redhasanh1/pinn-humanoid/robotai_BOM.xlsx

Sheet: BOM
robotai - Phase 1: Two InMoov-style robotic hands - Bill of Materials
All prices CAD, read from the linked pages on 2026-09-27. 3D-printed parts excluded (printing covered). Blue cells = inputs (edit price/qty); totals recalc automatically.
Budget (CAD) | $500.00 | Sales tax rate (ON HST) | 13%
CORE BOM
Item | Product Name | Link | Unit Price (CAD) | Quantity | Line Total (CAD) | Notes/Rationale
ESP32 dev board (x2, one per hand) | Freenove ESP32 Development Board ESP32 Kit (2 Pack) | https://www.amazon.ca/dp/B0C9THDPXP | $27.95 | 1 |  | One 2-pack covers both hands ($13.98/board). ESP32-WROOM, 4.4* (527), well documented.
Finger servos (10 + 2 spares) - GOOD tier | Deegoo-FPV MG996R Metal Gear Digital Servo, 4-Pack | https://www.amazon.ca/dp/B07MFK266B | $35.22 | 3 |  | 12 metal-gear standard servos, ~12 kg-cm @6V, $8.81/ea, 4.5* (1,182). Fits stock InMoov forearm. Showed 'only 6 left' - fallback: Aideepen MG996R 6-pack x2 (see Alternatives).
Servo driver (x2, one per hand) | HiLetgo PCA9685 16-Channel 12-Bit PWM Servo Driver (I2C), 2-Pack | https://www.amazon.ca/dp/B07BRS249H | $24.14 | 1 |  | Adafruit-layout clone, works with Adafruit PWM library on ESP32. One board per hand matches 1-ESP32-per-hand; a single board (16 ch) could drive all 10 servos but would tie both hands to one ESP32.
Servo power supply (x2, one per hand) | SHNITPWR 3.5-12V Adjustable 10A 120W Power Supply w/ LCD | https://www.amazon.ca/dp/B08N4FB7MF | $36.99 | 2 |  | Set to 6V. 10A = 5 MG996R running + 2-3 stalled (~2.5A stall each). LCD guards against accidental 12V. 4.3* (216). Servos NEVER on ESP32 5V pin; tie grounds.
DC barrel-jack to screw-terminal adapters | 20 PCS Female DC 5.5x2.1mm Barrel to Screw Terminal | https://www.amazon.ca/dp/B0C4JJ2HB4 | $11.99 | 1 |  | Connects PSU to PCA9685 V+ terminal. Small jacks run warm near 10A - cutting the plug and screwing wire in is safer.
Tendon line (shared spool) | HERCULES 8-Strand Braided PE Fishing Line, 50lb, 0.37mm, 100m | https://www.amazon.ca/dp/B0791D5G7J | $16.99 | 1 |  | InMoov-class braid, low stretch; 100m is far more than both hands need. 4.5* (7.7K). Price for 50lb/100m variant.
Finger return springs | Swpeet 150pc Stainless Extension Spring Assortment (15 sizes x 10) | https://www.amazon.ca/dp/B0D7W3RT31 | $20.99 | 1 |  | 10 of each size, so 10 matching springs per size for 10 fingers, lets you tune return force. 4.6* (111).
Jumper wire kit | ELEGOO 120pc 20cm Dupont Wire (40 M-F / 40 M-M / 40 F-F) | https://www.amazon.ca/dp/B01EV70C78 | $12.99 | 1 |  | Signal/I2C wiring ESP32<->PCA9685. 4.7* (14.8K). One kit covers both hands.
Servo extension cables | 10pc 30cm 3-Pin Servo Extension Cable (JR, F-M) | https://www.amazon.ca/dp/B09VGDJ6Z8 | $8.27 | 1 |  | Forearm servos to PCA9685 headers. Free shipping but slow (est. Oct 20-Nov 9); Prime alt in Alternatives.
Servo power wire | BNTECHGO 18 AWG Silicone Wire, Red/Black, 10ft | https://www.amazon.ca/dp/B01AQOI36M | $13.44 | 1 |  | 18AWG handles the 10A servo bus; Dupont wire (24AWG) must not carry servo power. 4.5* (438).
Core subtotal (pre-tax)
Est. HST on core (13%, shipping not included)
CORE TOTAL incl. tax
Headroom under budget
Under $500 CAD?
OPTIONAL - fingertip force sensors (NOT in core total)
Item | Product Name | Link | Unit Price (CAD) | Quantity | Line Total (CAD) | Notes/Rationale
Fingertip force sensors (x2, proof of concept) | Interlink FSR 402 (30-81794), genuine - DigiKey.ca | https://www.digikey.ca/en/products/detail/interlink-electronics/30-81794/2476468 | $10.43 | 2 |  | One per hand (e.g. index finger) on an ESP32 ADC pin via 10k divider. Qty-1 price break $10.43; qty 10 drops to $9.02/ea ($90.19) if you want all fingertips. DigiKey shipping for small orders NOT verified (free over $100 CAD). Amazon clones have 1 review - avoid.
Optional subtotal (pre-tax)
Core + optional, incl. tax
Still under $500 with sensors?
Notes
RECOMMENDATION: buy the core list + the 2 FSRs. Both fit comfortably under $500 CAD with tax, leaving room for shipping and a spare servo pack.
If you later want all 10 fingertips sensed, the DigiKey 10-pack ($90.19) still keeps core + sensors under $500 with tax.
Wiring rule: ESP32 3.3V/GND -> PCA9685 VCC/GND, SDA/SCL -> GPIO21/22. PSU (6V) -> PCA9685 V+ screw terminal. Common ground between PSU and ESP32. Never feed servos from the ESP32 5V pin.
Not included: shipping (most Amazon.ca items ship free with Prime or over $35), tools (soldering iron, crimper), and fasteners/bearings from the InMoov print list.
Prices change daily - re-check the links before ordering. See 'Alternatives' for budget/premium swaps and 'Phase 2 - Full robot' for arms/base.

Sheet: Alternatives
Alternatives & swaps (not in any total unless you swap them in)
Item | Product Name | Link | Pack Price (CAD) | Packs | Line Total (CAD) | Notes/Rationale
Servos - BUDGET tier | Miuzei MG90S Metal Gear Micro Servo, 10-Pack | https://www.amazon.ca/dp/B0BWJ26PX2 | $39.99 | 1 |  | Saves $65.67 vs MG996R, but only ~2 kg-cm and micro size: needs a remixed (non-stock) InMoov forearm. 4.5* (784).
Servos - cheapest metal-gear standard | Aideepen MG996R, 6-Pack | https://www.amazon.ca/dp/B09LS7RB5J | $39.99 | 2 |  | 12 servos for $79.98. Fallback if Deegoo sells out. Price from search results page. 4.3* (123).
Servos - alt MG996R | Miuzei MG996R Metal Gear, 4-Pack | https://www.amazon.ca/dp/B0BZ4N367M | $42.99 | 3 |  | Spec'd 15.2 kg-cm @6V. 4.4* (163).
Servos - PREMIUM tier | Miuzei 20KG DS3218 Metal Gear Digital, 180deg, 4-Pack | https://www.amazon.ca/dp/B0FH53CKCS | $65.99 | 3 |  | ~20 kg-cm, stronger grip; $197.97 for 12 (+$92 vs core). Search results price. 4.6* (47).
Servo driver - single board | JZK PCA9685 16-Channel PWM Driver (single) | https://www.amazon.ca/dp/B06XSFFXQY | $10.59 | 1 |  | One board can run all 10 servos, but then one ESP32 drives both hands. 4.3* (222).
Power - alt per-hand PSU | SHNITPWR 3.5-12V 12A 144W Adjustable | https://www.amazon.ca/dp/B0CKXW6ZCJ | $36.79 | 2 |  | More headroom, same price. 4.1* (102).
Power - ONE supply for both hands | Aclorol 5V 20A 100W Switching PSU (screw terminals) | https://www.amazon.ca/dp/B07KC55TJF | $39.44 | 1 |  | Saves ~$34 but max ~5.75V (less torque), single point of failure, exposed mains terminals need a cover. Needs AC cord below. 4.5* (182).
Power - AC cord for 20A PSU | Bergen 3ft 16AWG 3-wire pigtail cord | https://www.amazon.ca/dp/B07BQCMPF2 | $6.87 | 1 |  | Only with the single-PSU option. Search results price.
Barrel adapters - small pack | 2 Male + 2 Female 5.5x2.1 to Screw Terminal | https://www.amazon.ca/dp/B07JMY5XXT | $9.35 | 1 |  | Search results price. 4.6* (114).
Tendon - alt | Reaction Tackle Braided Line 50lb 150yd | https://www.amazon.ca/dp/B01MRMI7R1 | $21.41 | 1 |  | 4.3* (26.5K). Diameter not listed.
Springs - alt | Glarks 100pc Extension Springs, 25 sizes x 4 | https://www.amazon.ca/dp/B0D7CP84F4 | $20.95 | 1 |  | Only 4 per size - not enough matching springs for 10 fingers.
Jumper kit - alt | 240pc 10cm+20cm Jumper Wire Kit | https://www.amazon.ca/dp/B0BTT48V7P | $15.99 | 1 |  | Search results price. 4.6* (551).
Servo extensions - Prime alt | 10pc 30cm 3-Pin Servo Extension (Futaba/JR) | https://www.amazon.ca/dp/B07NJB58XC | $11.99 | 1 |  | Shipped by Amazon (faster). 4.4* (40).
Power wire - longer | BNTECHGO 18 AWG Silicone Wire 25ft | https://www.amazon.ca/dp/B07HGTKQ89 | $19.82 | 1 |  | Search results price.
FSR - 10 genuine (all fingertips) | Interlink FSR 402 (30-81794) x10 - DigiKey.ca | https://www.digikey.ca/en/products/detail/interlink-electronics/30-81794/2476468 | $90.19 | 1 |  | $9.02/ea at qty 10; one per fingertip on both hands.
FSR - Amazon clone | RELAND SUN FSR402-short (clone), sold singly | https://www.amazon.ca/dp/B0B5F7JDT5 | $8.19 | 10 |  | Only 1 review, +$9.50 shipping. Not recommended.

Sheet: Phase 2 - Full robot
Phase 2 - Life-size InMoov humanoid v1 (both arms on stock InMoov STLs + wheeled base) - prices in CAD
Both arms C$452.30 pre-tax (cap C$500). Whole phase 2 C$1077.15; plus the hands cart (already bought) C$316.40. Arm servos per arm: omoplate, rotate, bicep = DS5160 60 kg with the pot moved to the joint (Gael's mod); shoulder = DS5160 pot in place, limited 0-80; wrist + 5 fingers = owned MG996R. DS5160 is the HS-805BB footprint (65x30 mm) but 10 mm shorter: expect a printed spacer under the tabs; test-fit one before printing everything. Exact drop-in is the PDI-HV2060MG (~C$54 each, would break the cap). Removed vs round 3: 8x NFP 5840 worm motors, 8x BTS7960, 8x AS5600 (custom-arm parts that don't mount in InMoov STLs). The owned PCA9685s drive the arm servos.
 |  | USD->CAD rate (assumed, verify) | 1.38
Item | Product / Vendor | Link | Unit Price (CAD) | Quantity | Line Total (CAD) | Notes/Rationale
ARM: Big arm servos (omoplate, shoulder, rotate, bicep x 2 arms) | DS5160 SSG 60 kg HV digital servo, 180deg variant (RC Toys Upgrade Haven Store, 4.9 stars, 471 sold) | https://www.aliexpress.com/item/1005005676958064.html | $32.84 | 8 |  | ALIEXPRESS, FLAGGED: Amazon.ca DS5160 listings are C$50-57 each (one visible at C$56.75), so 8 of them would take C$400-450 of the C$500 cap. AliExpress shows free shipping. Pick the 180deg variant, not 270. 58 kg-cm at 6 V / 70 kg-cm at 8.4 V, about 2.5x an HS-805BB. The price could be a first-order deal, so re-check it in the cart. Amazon.ca fallback: ANNIMOS 60KG B07KTSCN4J (194 ratings), ZOSKAY B07K48FQ1N (85), 2-pack B09JGBW9KZ. [verified-on-page (AliExpress item page, C$32.84, free shipping)]
ARM: Arm servo power (one per arm, set to 7.4 V) | SHNITPWR 3.5-12V adjustable 12A 144W PSU | https://www.amazon.ca/dp/B0CKXW6ZCJ | $36.79 | 2 |  | Same family as the hand PSUs you already own. Each one runs the 4 big servos of one arm. The worm joints hold their position with the power off, so only 1-2 servos load up at a time. Gael runs a single 6 V 40-60 A supply for the whole robot; splitting per arm means one supply can't brown out the whole robot. Alternative: Aclorol 5V 60A B07KC3KSHP at C$51.38 (verified on the search page), but it only reaches about 5.5 V. [price from the existing bom.json alternatives (earlier check), not re-verified today because Amazon.ca hides prices on a Santa Clara address]
ARM: M3/M4 countersunk bolts + nuts | DYWISHKEY 500pcs M3 M4 M5 304 stainless flat-head countersunk socket cap screws + nuts | https://www.amazon.ca/dp/B08QD6TT2N | $35.47 | 1 |  | InMoov BOM calls for about 50x M3x20 and 50x M4x20 countersunk, plus M3 nuts. Check the kit goes up to 20 mm (the thesis lists 3 mm screws at 12/20/30/35 mm). This overlaps the phase2 'Hardware' line (LuKaiSen kit C$15.99); you can drop that kit's screws and keep only the heat-set inserts. [verified on the Amazon.ca search results page (C$35.47, 55 ratings)]
ARM: Spare 10k pots for the pot-relocation mod | uxcell WH148 10K rotary potentiometer, 10 pcs | https://www.amazon.ca/dp/B07JM62B3Q | $13.99 | 1 |  | The first choice is to reuse each servo's own pot on an extension lead (Gael: cut the wires and splice in length, don't desolder at the PCB). Builders break these pots by over-rotating them, so spares are needed. The pot works as a voltage divider, so a 10k pot replacing a ~5k pot still works. Gael uses round pots (PivPotentioRound) and a square version exists; a WH148 needs a holder like Thingiverse thing:6923985 (shoulder, metal linear pot) or thing:1464929 (bicep, square pot). The listing title says 'Dual'; if it turns out to be dual-gang, use one gang. [verified on the Amazon.ca search results page (C$13.99); single vs dual gang not confirmed]
ARM: 6 mm BBs for the shoulder/rotate ball races | Lancer Tactical 0.20 g 6 mm BBs, 4000-round bag | https://www.amazon.ca/dp/B00HC1U0LO | $13.00 | 1 |  | Per arm: PivCenter 27 + PivMit 31 + RotCenter 27 + RotMit 31 = 116 balls, so 232 for both arms. The classic InMoov arm needs no other ball bearings. Gael warns that some greases dissolve plastic BBs, so use PTFE/silicone grease only. Canadian Tire sells the same BBs for about the same price. [estimate (Amazon.ca hides the price for this delivery address)]
ARM: Servo extension leads (pot relocation + reaching the PCA9685) | 10pc 30cm 3-pin servo extension cable (JR, F-M) | https://www.amazon.ca/dp/B09VGDJ6Z8 | $8.27 | 2 |  | 3 relocated pots per arm need 25-35 cm leads, plus the 8 big servos need to reach the controller. Same SKU as the phase1 cart. [price from phase1 bom.json (earlier check)]
ARM: Servo mounting wood screws | Self-tapping screw assortment incl. M3x12 and 3.5x16 mm (4 per big servo) | https://www.amazon.ca/s?k=self+tapping+screw+assortment+m3 | $10.00 | 1 |  | InMoov BOM: about 100x M3x12 for small servos and about 50x M4x20 for large servos. Use a hardware store if that's cheaper. [estimate]
ARM: M8 through-bolts | M8x90-100 mm bolts + nylock nuts (about 6) | https://www.homedepot.ca/ | $15.00 | 1 |  | One M8x90 per shoulder-to-Clavi joint, plus the elbow and wrist axles (the wrist uses an 8 mm x 6 cm bolt). The InMoov BOM lists about 15x M8x100 for the whole robot. A hardware store is cheapest. [estimate]
ARM: Worm/gear grease | PTFE grease (Super Lube 21030 class) | https://www.amazon.ca/s?k=super+lube+ptfe+grease | $12.00 | 1 |  | Needed on the PivWorm/RotWorm and the ball races. Must not attack ABS/PLA or the plastic BBs. [estimate]
Neck x2 + spares | Feetech STS3215 12V 30 kg-cm bus servo, 6-pack (official store) | https://www.aliexpress.com/item/1005008670304643.html | $166.42 | 1 |  | C$160.99 + C$5.43 shipping, 4.9 stars, 232 sold. Checked on the page. Wrists moved to the owned MG996Rs (InMoov wrist uses MG996R).
Drive base | Used hoverboard (2x 350 W hub motors + 36 V pack) | https://www.kijiji.ca/b-city-of-toronto/hoverboard/k0c170l1700273 | $120.00 | 1 |  | C$50-150 on Kijiji Toronto (43 ads). Open it before paying: single mainboard with STM32F103RCT6/RET6 or GD32F103RCT6 only; walk away from AT32F403/413 boards. Runs EFeru FOC firmware (free).
Base power converter | DC-DC buck 30-60 V in -> 12 V, 15 A+ | https://www.amazon.ca/ | $40.00 | 1 |  | Estimate C$35-45. Must accept 42 V (a 36 V pack charges to 42 V), so an 18-36 V input unit will fail.
Casters (x2) | 2 in swivel casters | https://www.amazon.ca/ | $20.00 | 1 |  | Estimate. Stabilize the tall torso on the hoverboard base.
Safety + power wiring | E-stop button, fuses, XT60 connectors, 14 AWG wire | https://www.amazon.ca/ | $30.00 | 1 |  | Estimate. Non-negotiable for a 1.8 m robot on wheels.
Servo bus adapters (x2) | Waveshare Bus Servo Adapter (A) | https://www.waveshare.com/bus-servo-adapter-a.htm | $6.99 | 2 |  | US$4.99 on waveshare.com; Canada shipping not checked.
Head camera | EMEET C960 1080p webcam | https://www.amazon.ca/dp/B07M6Y7355 | $34.99 | 1 |  | 4.4 stars, 32.5K ratings.
Wrist cameras (x2) | 1080p UVC wide-angle camera module | https://www.aliexpress.com/w/wholesale-wide-angle-usb-camera.html | $12.00 | 2 |  | Estimate. Can wait until week 3.
Balance / motion sensor | BNO085 9-axis IMU (clone) | https://www.aliexpress.com/w/wholesale-bno085.html | $17.58 | 1 |  | Adafruit original is C$33-40.
Servo cables (x2 packs) | 5264 3-pin bus servo cable, 10-pack | https://www.aliexpress.com/item/1005008074862037.html | $6.72 | 2 |  | + ~C$8 shipping.
Powered USB hub | 7-port powered USB 3.0 hub (TP-Link UH700 class) | https://www.amazon.ca/dp/B00OTK16FK | $65.00 | 1 |  | Checked: C$59-71 for reputable hubs.
Hardware | M2/M3/M4 screw kit + 100 M3 heat-set inserts | https://www.amazon.ca/ | $27.00 | 1 |  | LuKaiSen kit C$15.99 + HANGLIFE inserts C$10.99.
Work stand clamps | WEN CLC424 C-clamps, 2-pack | https://www.amazon.ca/dp/B08SQFT9TW | $17.44 | 1 |  | Holds the torso on the bench during arm bring-up.
Wire + connectors | Assorted wire, JST/Dupont, heat shrink | https://www.amazon.ca/ | $35.00 | 1 |  | Estimate.
Phase 2 subtotal (CAD, pre-tax/shipping)
Whole v1 incl. the hands cart (Phase 1 core)
Under the C$1,500 budget by
Cerebras = System-2 brain (planner, voice, replanning, success checks) in the cloud; ACT/SmolVLA motor policy runs locally at 30-50 Hz. See research brief.

Sheet: Phase 3 - Tools
Phase 3 - Tools + last parts (in the Amazon.ca cart, NOT ordered yet)
Checked with Kimi (senior build manager) on 2026-09-27: cut the crimper and breadboard, swapped the wrench set for one 13 mm wrench, added nylock nuts, files, sandpaper, knife, tweezers, fuses, switch. Breadboard kit re-added at Hasan's request (Kimi had marked it optional). Recheck vs orders: the DC barrel-to-screw adapters from Phase 1 were never ordered; added.
Item | Product Name | Link | Unit Price (CAD) | Quantity | Line Total (CAD) | Notes/Rationale
Head camera (robot's live eyes) | InnoMaker 1080P USB UVC camera, 130deg wide | https://www.amazon.ca/dp/B0CNCSFQC1 | $28.00 | 1 |  | Board 38 x 38 mm, plugs into USB, no driver. Kimi: keep.
Arm pivot bolts | M8 x 100 mm socket cap bolts, 10-pack | https://www.amazon.ca/dp/B07KRTHJZR | $11.41 | 1 |  | 8 mm thick, 100 mm long. Shoulder, bicep, omoplate pivots (InMoov BOM: M8x100 x15).
Lock nuts for the M8 bolts | M8 x 1.25 nylon-insert lock nuts, 20 pcs | https://www.amazon.ca/dp/B075ZZY166 | $8.99 | 1 |  | 13 mm across. Stops the pivot bolts backing out.
13 mm wrench (for M8 nuts) | Sunex 13 mm combination wrench | https://www.amazon.ca/dp/B00BNS8W2Q | $9.82 | 1 |  | Only size the M8 nuts need.
Ball race balls | 6 mm 0.20 g airsoft BBs | https://www.amazon.ca/dp/B07T3K1TMS | $12.39 | 1 |  | 6 mm balls. 31 per bicep race, 62+ for two arms.
Grease for the ball races | Super Lube 92003 silicone grease | https://www.amazon.ca/dp/B0081JE0OO | $25.55 | 1 |  | For the printed gears and races.
Joint position sensors | uxcell WH148 10k potentiometers, 10 pcs | https://www.amazon.ca/dp/B07JM62B3Q | $13.99 | 1 |  | Shaft 6 mm. Pot relocated to the joint (InMoov mod).
Servo extension leads | 30 cm 3-pin servo extension, 5 pcs | https://www.amazon.ca/dp/B07DMTYQ6N | $10.32 | 2 |  | 30 cm each, 10 total.
Power plug adapters (PSU to boards) | 20 pcs 5.5 x 2.1 mm DC barrel to screw terminal | https://www.amazon.ca/dp/B0C4JJ2HB4 | $11.99 | 1 |  | Was in the Phase 1 plan but never ordered. Connects the 2 power supplies to the PCA9685 servo boards.
Wire joiners | WAGO 221 lever connectors, 25 pcs | https://www.amazon.ca/dp/B0BYBHYLG2 | $29.39 | 1 |  | Join power wires without soldering.
Fuses | 12 AWG inline fuse holders, 4 pcs | https://www.amazon.ca/dp/B0FDJYRGB7 | $9.99 | 1 |  | 10 A fuse on each power supply line.
Main power switch | Nilight rocker switch 20 A | https://www.amazon.ca/dp/B06ZZHX6K3 | $4.62 | 1 |  | One switch kills servo power.
Screwdrivers | STREBITO 124-piece precision screwdriver set | https://www.amazon.ca/dp/B0968D5PSC | $25.99 | 1 |  | Phillips PH0-PH2 + hex bits for M2-M4 screws.
Hex keys | GEARWRENCH 9-piece metric ball-end hex keys | https://www.amazon.ca/dp/B098TYMJ3X | $10.99 | 1 |  | 1.5-10 mm. Your countersunk kit: 2 mm = M3, 2.5 mm = M4. 6 mm = the M8 bolts.
Pliers + cutter | SPEEDWOX mini long-nose pliers with cutter | https://www.amazon.ca/dp/B0CGHRCHP5 | $9.69 | 1 |  | Cheap single tool: grip + snip.
Wire stripper | Solsop self-adjusting wire stripper | https://www.amazon.ca/dp/B07XXMLFMV | $10.19 | 1 |  | Strips 10-24 AWG.
Soldering iron | 60 W adjustable soldering iron kit | https://www.amazon.ca/dp/B08K8VFTF9 | $13.99 | 1 |  | Cheapest decent kit (446 reviews).
Solder | TOWOT 63/37 rosin-core solder 0.8 mm | https://www.amazon.ca/dp/B0943TPRXK | $12.97 | 1 |  | 0.8 mm wire, easy for beginners.
Multimeter | Digital multimeter | https://www.amazon.ca/dp/B07H65J7DQ | $19.98 | 1 |  | Must-have: check each power supply's voltage before plugging servos in (12 V by mistake burns 6 V servos).
Breadboards + jumper wires | 830 + 400 point breadboards with jumper wire kit | https://www.amazon.ca/dp/B0BMFXPSVG | $19.99 | 1 |  | Test sensors/servo signals before soldering. Kimi said optional; re-added because Hasan asked.
Heat shrink | ASHINER heat shrink kit, 580 pcs | https://www.amazon.ca/dp/B08XXGNJHG | $14.99 | 1 |  | Covers solder joints.
Calipers | ADORIC digital caliper 0-150 mm | https://www.amazon.ca/dp/B07DFFYCXS | $11.43 | 1 |  | Measure screws and printed parts.
Zip ties | 400 assorted zip ties | https://www.amazon.ca/dp/B08TVLYB3Q | $11.98 | 1 |  | Cable management.
Hot glue | Surebonder LT-160 mini glue gun | https://www.amazon.ca/dp/B004BPPHYE | $7.47 | 1 |  | InMoov wire management method.
Needle files | 10-piece needle file set | https://www.amazon.ca/dp/B07PPYWSCY | $9.99 | 1 |  | Fit printed parts (ball races, pistons). Kimi: day-1 blocker.
Sandpaper | 3M sandpaper 100/150/220 grit, 5 sheets | https://www.amazon.ca/dp/B00004Z48U | $7.97 | 1 |  | Smooth printed parts.
Hobby knife | VViViD modelers knife + spare blades | https://www.amazon.ca/dp/B0CL5F9M4H | $7.98 | 1 |  | Clean up prints.
Tweezers | NARZ 4-piece tweezers | https://www.amazon.ca/dp/B09JLXKWB5 | $6.29 | 1 |  | Threading finger tendons.
Safety glasses | Clear safety glasses, 3-pack | https://www.amazon.ca/dp/B0F2JL22QN | $13.49 | 1 |  | For cutting, soldering, springs.
Subtotal (CAD, pre-tax)
With HST 13%

Sheet: Screw sizes
Screw sizes: what goes where
Part | Thick (mm) | Long (mm) | Goes in | Tool | Status
M8 x 100 mm bolt | 8 | 100 | Shoulder, bicep, omoplate pivots - the arm hangs on these | 6 mm hex key + 13 mm wrench | in cart
M8 x 60 mm bolt | 8 | 60 | Elbow / forearm shaft only (too short for the shoulder) | 6 mm hex key + 13 mm wrench | ordered
M4 x 20 mm bolt | 4 | 20 | Joining printed parts together | 2.5 mm hex key | ordered (DYWISHKEY kit)
M3 x 20 mm bolt | 3 | 20 | Joining small printed parts | 2 mm hex key | ordered (DYWISHKEY kit)
3.5 x 16 mm self-tapper | 3.5 | 16 | Screwing servos into plastic (bicep build) | Phillips PH2 | ordered (625 pc kit)
M2 x 8 mm self-tapper | 2 | 8 | Servo horns, hand parts | Phillips PH0/PH1 | ordered (625 pc kit)
6 mm ball (BB) | 6 | 6 | Shoulder / bicep ball races, 31 per race | grease | in cart
