redhasanh1/pinn-humanoid/build/prints/day3_newnham_mon/PLATE_1_print_first_RE4_elbow_RS4.3mf

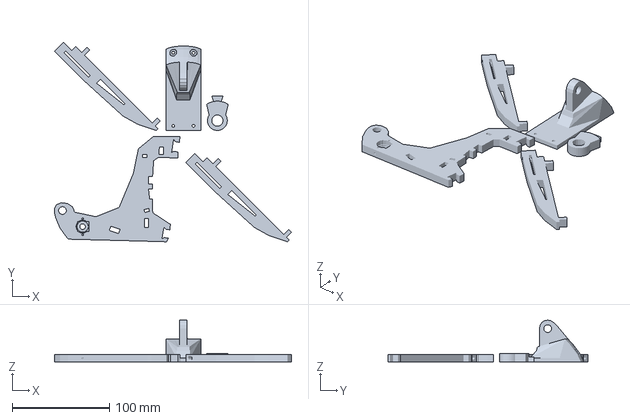
[picture p1: CAD file, 2026-10-05]
build/prints/day3_newnham_mon/PLATE_1_print_first_RE4_elbow_RS4.3mf
244.0 x 205.5 x 43.1 mm
