redhasanh1/pinn-humanoid/build/prints/day4_Oct6_SenecaYork/PLATE_4_RO2_omoplate.3mf

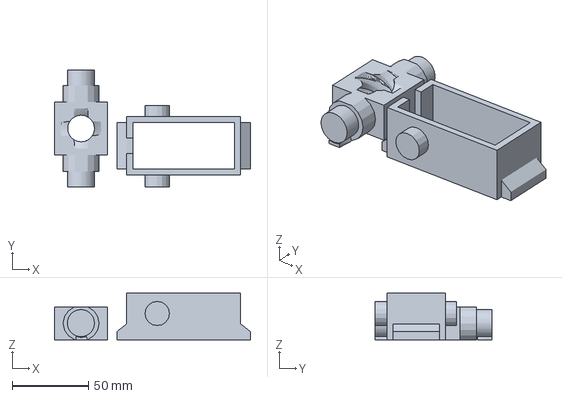
[picture p2: CAD file, 2026-10-06]
build/prints/day4_Oct6_SenecaYork/PLATE_4_RO2_omoplate.3mf
128.9 x 76.9 x 30.7 mm
