redhasanh1/pinn-humanoid/build/prints/day3_newnham_mon/PLATE_2_print_second_RS2_shoulder_gears.3mf

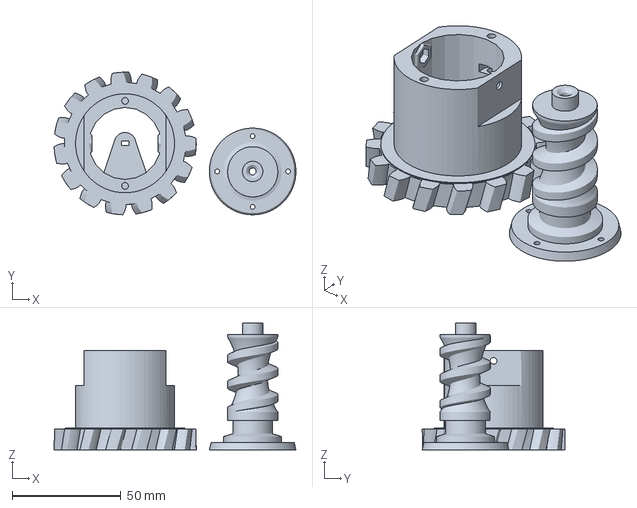
[picture p3: CAD file, 2026-10-05]
build/prints/day3_newnham_mon/PLATE_2_print_second_RS2_shoulder_gears.3mf
111.5 x 65.7 x 58.4 mm
