redhasanh1/pinn-humanoid/build/prints/day4_Oct6_SenecaYork/PLATE_5_RR3_rotate.3mf

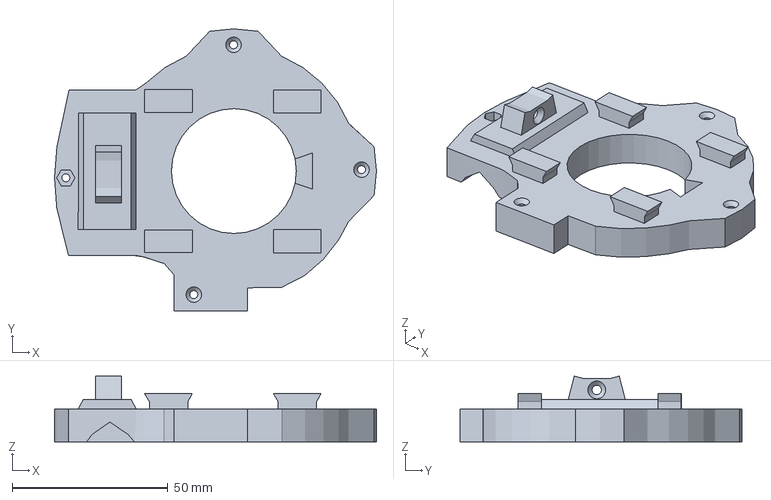
[picture p4: CAD file, 2026-10-06]
build/prints/day4_Oct6_SenecaYork/PLATE_5_RR3_rotate.3mf
103.5 x 90.7 x 21.2 mm
