redhasanh1/pinn-humanoid/build/prints/day4_Oct6_SenecaYork/PLATE_6_RE5_elbow_gears.3mf

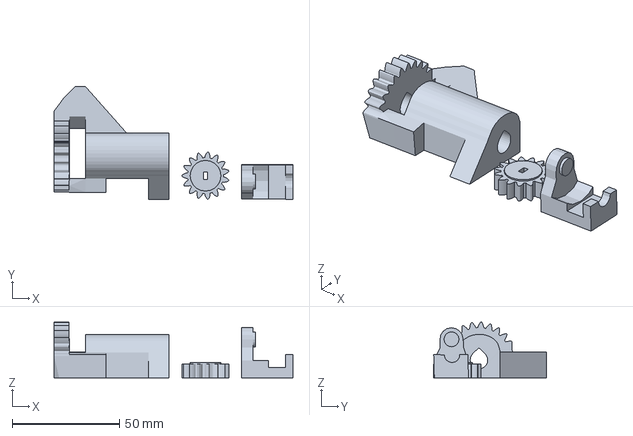
[picture p5: CAD file, 2026-10-06]
build/prints/day4_Oct6_SenecaYork/PLATE_6_RE5_elbow_gears.3mf
111.3 x 52.4 x 26.0 mm
