redhasanh1/pinn-humanoid/(commit log)

2026-09-26 Test: an obstacle that really blocks the real grasp, and zero contact
    test_moves_an_object_that_is_in_the_way put the cup 6 cm to the SIDE of
    the plate. With real grasps the flat plate is slid out to the counter
    edge and taken by its overhang, so a cup beside it is no longer in the
    way - the robot picked the plate cleanly without moving anything (0
    contacts in the replay) and the test failed on the missing 'moving the
    cup out of the way'. The cup now sits 7 cm in FRONT of the plate, on the
    slide path: the robot moves it aside, takes the plate, and the 50 Hz
    replay shows no contact (new assert).
    Full pytest on this code: 65 passed + this one = 66/66 (the full run
    took 16 min; the grasp planni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
2026-09-26 Docs: real grasps write-up (results/grasps.md) and SOFTWARE.md
    Before/after table (grab gap 12-19 cm above the object -> 0.2-1.2 cm;
    47/47 house tasks with 0 contacts > 2 mm in the replay, capsule arms),
    why it was wrong (palm target 12 cm from the wrist, wrist bend unused,
    fingers curl up into a fist), the six things that fix it, how to check
    it, and what is pending (the mesh-model run). SOFTWARE.md: the spill is
    now solved by the AI (49/50) and the grasps section.
2026-09-26 Grasp solver 3x faster (exact Jacobians); shape-generalised grasp memory
    Profiling the sponge pick (36 s): 372 000 calls to mj_forward from
    solve_grasp - full forward dynamics including collision detection, 7
    evaluations per IK step (finite differences over 6 joints).
    - resid(): mj_kinematics + mj_comPos only (positions, no collisions).
    - Exact Jacobian from mj_jacBody: grasp point g = (palm + mean tips)/2
    so Jg = (Jpalm + mean Jtips)/2; hand axis h = v/|v|, v = palm - wrist,
    so Jh = (I - h h^T)(Jpalm - Jwrist)/|v|. One evaluation per step.
    Same answers, same checks:
    put the sponge in the sink 36 -> 11.4 s, clean, 0 contacts
    do the dishes 13 -> 4.6 s, clean, 0 conta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
2026-09-27 Add Blink camera tools: login with SMS 2FA, snapshots, live view
    The Blink Mini 2K+ ("Garage") is cloud-only. On the Mac, ioreg/system_profiler
    showed its USB port is power-only both before and after a replug, and it has no
    local RTSP or firmware path (Immedia AC1002B SoC, confirmed with Kimi). So it is
    reached through blinkpy 0.25.5.
    - login.py: one-time login where the user types their own credentials. Blink's
    SMS two-step sign-in answers HTTP 202 (with tsv_methods), but blinkpy 0.25.5
    only treats 412 as "2FA needed" and gave up with "Login failed". The patch
    treats 202 as 2FA, prompts for the code, and prints Blink's replies. The
    verify step returned 201 "auth-completed". The tok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
2026-09-27 Fix Blink live view dying after about 16 s
    blinkpy 0.25.5's BlinkLiveStream.recv() reads each IMMI packet with
    reader.read(n), which returns up to n bytes. The first time TCP split a packet it
    logged "Insufficient data for payload: 114 bytes, expected 1316" and tore down
    the whole session. Measured before the fix: 15.5 s to the first frame, 2 frames,
    session dead at 16 s, on every attempt.
    stream_fix.patch() swaps in a recv() that uses readexactly() for the 9-byte
    header and the payload. The protocol and filtering are unchanged (only msgtype 0
    MPEG-TS packets are forwarded), and an IncompleteReadError now means Blink closed
    the stream. live.py applies the patch and plays with low-latency ff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
2026-09-27 Add tools/drive.py: drive and spin the robot with the arrow keys
    Hasan asked whether the robot can be moved around and turned 360 degrees by hand
    in the house sim. There were no controls for that: the base joints (base_x,
    base_y, base_yaw) only moved during task playback.
    drive.py opens the same house scene (build_model with mobile=True and
    home.scene_xml()) and hooks the passive viewer's key_callback:
    - Up/Down: 10 cm forward/back along the heading
    - Left/Right: 15 degree turns (hold to spin a full 360)
    - Page Up/Down: 10 cm strafe
    - Home: back to the start spot
    The camera stays manual (mouse/touchpad), as Hasan prefers. The base is set
    kinematically with mj_forward, like motor.play, and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
2026-09-27 Blink live view: show each frame the moment it arrives
    The live view ran about 3 s glass-to-screen (Hasan's hand test). Part of that was
    ffplay itself: it probed the stream, buffered for A/V sync, and paced frames by
    their timestamps.
    live.py now plays with -fflags nobuffer+discardcorrupt, -flags low_delay,
    -probesize 32, -analyzeduration 0, -an, -sync ext, -framedrop and -vf setpts=0.
    With setpts=0 every decoded frame is presented immediately instead of being
    scheduled against the stream clock, so no player-side queue can build up.
    Hasan confirmed it is visibly faster over AnyDesk. It was not measured: the
    remaining delay is Blink's camera -> cloud relay -> PC path, which the client
    canno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
2026-09-27 Phase 3 parts: tools + last arm parts (in cart), and a screw-size guide
    Hasan owns no tools and asked for everything still missing, within C$500,
    Prime only, checked with Kimi, with the sizes spelled out. He also said the
    screws he received looked far too big.
    The Amazon.ca cart holds 28 items: C$370.18 pre-tax, C$418.30 with 13% HST.
    Nothing has been ordered.
    - Robot parts: InnoMaker 1080p 130deg UVC head camera; M8x100 bolts plus 20 M8
    nylock nuts; 6 mm BBs for the ball races; Super Lube; WH148 10k pots; 10x
    30 cm servo extensions; WAGO 221 connectors; 10 A inline fuses; rocker switch.
    - Tools, cheapest decent pick each: precision screwdriver set, metric hex keys,
    long-nose pliers w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
    [robotai_BOM.xlsx]
2026-09-27 Phase 3: re-add breadboard kit, note why the multimeter is a must-have
    Hasan asked for breadboards and wires. Kimi had marked the kit optional (the
    ESP32 dev board + Dupont + WAGO cover prototyping), but it is C$19.99 and the
    budget has room, so it's back (B0BMFXPSVG, 830 + 400 point + jumpers).
    A friend of Hasan's warned that without a multimeter things get blown up. It is
    already in the cart (B07H65J7DQ, C$19.98). Its note now gives the reason: check
    each adjustable PSU before plugging servos in, since 12 V by mistake burns the
    6 V MG996R hand servos.
    Cart: 29 items, C$390.17 pre-tax, about C$441 with HST. Nothing ordered.
    [robotai_BOM.xlsx]
2026-09-27 Phase 3: add the DC barrel adapters that were never ordered
    Hasan asked whether anything else was missing. I compared every Phase 1 core
    line against the Amazon.ca order history (ESP32, MG996R x12, PCA9685, 2x
    SHNITPWR, PE braid, springs, Dupont, 18 AWG wire all present). One gap: the
    5.5x2.1 mm DC barrel-to-screw-terminal adapters (B0C4JJ2HB4) were planned but
    never bought. Without them the power supplies can't be wired to the PCA9685
    V+ terminals without cutting the plugs off. Added at C$11.99.
    Cart: 30 items, C$402.16 pre-tax, about C$454 with HST. Nothing ordered.
    [robotai_BOM.xlsx]
2026-09-27 Share the Blink live view with friends: password-protected web stream
    Hasan wanted friends to see the live camera, and asked whether putting it on a
    website would make it slower.
    share.py keeps a Blink live session running (stream_fix readexactly patch) and
    starts a new one whenever Blink ends it. ffmpeg decodes it to JPEG frames at
    10 fps and 960 px wide, and a small aiohttp server pushes the newest frame to
    every open page (MJPEG). A slow viewer skips frames instead of falling behind.
    Added delay is about 0.3-1 s on top of Blink's own ~3 s.
    Access: HTTP basic auth (user robotai) or /stream?key=..., which the site's
    /live page uses after asking for the password. The password is generated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
2026-09-27 Site: /live page for the home camera stream
    Friends open /live, type the password Hasan gives them, and the page embeds the
    stream from the home PC (tools/blink/share.py on the real-grasps branch,
    exposed through a Cloudflare tunnel). The stream is about 3-4 s behind real
    time and ~2 Mbps per viewer.
    - site/live.html: reads /data/live.json for the current tunnel URL. On submit
    it sets <img src=URL/stream?key=...>. It says "camera is off" when there's no
    URL, and "wrong password or PC off" if the image fails.
    - data/live.json: the current trycloudflare URL. Quick-tunnel URLs change each
    time the tunnel restarts, so this file must be updated then (a named tunnel
    on a Cloudflare accoun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
2026-09-27 Fix Railway deploys: force the Node provider in railpack.json
    Every deploy of the site service since 2026-09-26 14:39 has failed, so the live
    site is stuck on an older build (the /live page 404s). The build log:
    Railpack 0.40.0 "Detected Python, Using pip, No start command detected". Once
    requirements.txt landed at the repo root for the robot code, Railpack picked the
    Python provider instead of Node, and found no main.py/app.py to run.
    railpack.json pins provider "node" with deploy.startCommand "node server.js",
    which is what package.json's server has always been.
2026-09-30 Site: new "The AI" page (3D neural net, live PINN demo, control loops); Cerebras wording fixed
    New page /ai (site/ai.html + site/ai.js, linked from every page's nav and a home tile):
    - A neural network you can orbit (three.js 0.160, OrbitControls): 25 camera-pixel inputs -> two
    20-node learned layers -> 8 joint outputs, ~500 of the connections drawn, 70 pulses flowing layer
    to layer and lighting nodes as they arrive, labels "what it sees / learned layers / its next moves".
    Auto-rotates unless prefers-reduced-motion.
    - Physics-informed neural networks, interactive: a ball's true flight (gravity + quadratic drag,
    K = 0.35), six noisy measurements; "Physics loss: off" draws a degree-5 l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
2026-09-30 Site: Physics AI first on the home page, research rebuilt as 5 short docs, old docs removed
    Home page (site/index.html) is now ordered for someone seeing the project for the first time:
    1. Big headline "Physics-informed AI that teaches a humanoid to learn." (new .hero-xl, clamp 36-68 px)
    with buttons to the AI, research and robot sections.
    2. The full Physics AI content inline (3D network, PINN demo, control loops, results, direction),
    ai.js now also loaded on the home page.
    3. Research cards linking to the new docs.
    4. The robot (3D model, jobs, stats, tiles).
    Nav on every page: Physics AI, Research, then arm/legs/plan/parts/live. /ai page renamed "Physics AI".
    Home stats: dropped "pl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
2026-10-05 Build tracker: print status for all 24 plates, parts list, robot PC tests
    Adds build/ as the one place to track the physical right-arm build:
    - PRINT_LOG.txt: all 24 print plates with status (6 DONE: whole hand + RF2;
    5 on today's Newnham plates; 3 left for Hasan; 10 for the friend's 10 h runs).
    Times are real PrusaSlicer times (MK4S HF0.4, 0.20mm SPEED, 30% infill, 4 perimeters).
    - prints/day3_newnham_mon: two combined plates for Mon Oct 5 (whole day booking):
    PLATE 1 RW1+RW2+RS4 2h57 84 g @0.20, PLATE 2 RW3+RE5 gears 2h22 41 g @0.15 = 5h19.
    The day2 RW1 copy was off-bed (sliced as 2h59/83 g); the fixed file is ~1h39.
    - FINAL_PARTS_CHECKLIST.txt: hardware owned/ordered/to buy and re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
    [PLATE_1_print_first_RW1_RW2_RS4.3mf, PLATE_2_print_second_RW3_RE5_gears.3mf]
2026-10-05 Print tracker: Oct 2 prints were RW1+RW2 and RW3+RE5+RR3, 11 of 24 plates done
    The two Oct 2 gcodes in C:\hi\day2 were combined plates, not single parts:
    - '1_printer1_RW1...2h59m' holds RW1 + RW2 (83 g)
    - '3_printer1_RW3...4h36m' holds RW3 + two merged plates; 81 g total = RW3 16 g + RE5 24 g + RR3 39 g
    So RW1, RW2, RW3, RE5 and RR3 are marked DONE (Oct 2) and the whole wrist is printed.
    Today's Newnham plates (whole-day booking) re-planned to only unprinted parts:
    - PLATE A: RO2 omoplate + RS4 pot ring, 2h00, 62 g @0.20 mm
    - PLATE B: RS2 shoulder gears, 2h47, 57 g @0.15 mm
    Total 4h47. After today all 13 of Hasan's small plates are printed; the friend's 10 big
    runs (RF1 forearm first) are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
    [PLATE_1_print_first_RW1_RW2_RS4.3mf, PLATE_2_print_second_RW3_RE5_gears.3mf, PLATE_A_print_first_RO2_RS4.3mf, PLATE_B_print_second_RS2_shoulder_gears.3mf]
2026-10-05 Print tracker: today's plates are RE4+RS4 and RS2; RE5/RR3/RO2 unconfirmed
    Oct 5 Newnham plan (whole-day booking, 9:45-4:00):
    - PLATE 1: RE4 elbow (LowArmSide 2/2, servobase, 2x Reinforcer) + RS4 pot ring, 2h42, 83 g @0.20 mm
    - PLATE 2: RS2 shoulder gears (PivGear + PivWorm), 2h47, 57 g @0.15 mm
    Total 5h29. Both picked from parts that are certainly unprinted, so nothing is duplicated.
    RE4 moved from the friend's run5 to Hasan.
    Status correction: the Oct 2 '4h36' gcode held RW3 plus two merged plates whose
    footprints don't match any plate as laid out (rotated/rearranged in the slicer), so
    RE5, RR3 and RO2 are marked '?' (in the day-2 plan, probably printed) until checked.
    Confirmed done: who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
    [PLATE_1_print_first_RE4_elbow_RS4.3mf, PLATE_2_print_second_RS2_shoulder_gears.3mf, PLATE_A_print_first_RO2_RS4.3mf]
2026-10-06 Print tracker: Oct 6 York printed RR3 + RE5; Oct 2 print was RW3 + RO2 + RR3
    Matched the Oct 2 York gcode's three objects by printed height:
    - 17.0 mm = RW3 wrist gears (17.1), 30.8 mm = RO2 omoplate (30.7), 21.6 mm = RR3 rotate (21.2).
    RE5 (26 mm) was not in it.
    Oct 6 York (Printer #1, 9:45-3:00, 5-booking/day cap) printed PLATE 5 RR3 (now a spare) and
    PLATE 6 RE5 elbow gears, both 40% infill, MK4S HF0.4 (plate files in build/prints/day4_Oct6_SenecaYork).
    Status: 12 of 24 done (hand x5, RF2, wrist x3, RO2, RR3, RE5). Monday's Newnham plates
    (RE4 + RS4, RS2 gears) are marked unconfirmed until checked. The friend holds the 9 big plates
    (RF1, RE1, RE2, RE3, RS1, RS3, RR1, RO1, RR2) from the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
    [PLATE_4_RO2_omoplate.3mf, PLATE_5_RR3_rotate.3mf, PLATE_6_RE5_elbow_gears.3mf]
